bradrblack/vibration-monitor/(commit log)

2026-09-19 Add ESP32-C3 sump pump vibration monitor
    Reads an ADXL345 at 400 Hz, high-passes and RMS-windows the signal, and
    debounces a pump running/stopped state. Reports state changes (max one per
    minute) to the Adafruit IO "pump" feed and each run's exact length to
    "pump-run-seconds". LED shows movement, and blinks while the pump is on.
    Includes Wi-Fi reliability fixes (reduced TX power, radio reset and reboot
    fallback) and lib_ignore for WiFi101/WiFiNINA, which shadow the ESP32 WiFi.h.
    Claude-Session: https://claude.ai/code/session_016Ek1563o3tDYY9ggsTUYb5
    [pump-sensor.ino]
2026-09-20 Add reliability hardening and ntfy notifications
    Borrows the self-healing approach from the rf-ceiling-fan-remote firmware:
    - Bounded Wi-Fi connect at boot, Wi-Fi watchdog, Adafruit IO watchdog
    - Nightly 3 AM reboot (NVS-guarded, held off while pump running or a
    report is unsent)
    - Reboot reasons persisted to flash and pushed via ntfy.sh on next boot,
    including crash/watchdog/brownout detection
    - I2C hardening: ADXL345 device-ID watchdog, bus recovery at boot, and a
    notification if the sensor is missing
    - Last published state persisted so a reboot can't leave the feed stuck
    on "running"
    - Optional pump ON/OFF ntfy pushes, rate limited like the Adafruit feed
    - Timestamped logging and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
    [pump-sensor.ino]
2026-09-20 Generalize to multi-device appliance monitor with JSON events
    Rename pump-sensor.ino to vibration-monitor.ino, publish start/stop events
    as JSON to a shared appliance-events feed, and move per-device tuning into
    PlatformIO environments. README updated to match.
    [vibration-monitor.ino]
2026-09-20 Publish JSON events via MQTT and add I2C boot diagnostics
    Publish events through the Adafruit IO MQTT client (wrapped as {"value":...})
    because AdafruitIO_Feed::save() truncates payloads over 45 bytes.
    Add an I2C scan/idle-level log when the ADXL345 is not detected at boot, and
    retry accel.begin() up to 5 times since the first call often fails on the
    ESP32 Arduino 3.x I2C driver (ESP_ERR_INVALID_STATE) even when wired correctly.
    Bump firmware to 2026-09-20r9.
    [vibration-monitor.ino]
2026-09-21 Add Telegraf and Grafana setup for the InfluxDB appliance timeline
    Telegraf drop-in config subscribes to the Adafruit IO feed over MQTT and writes
    each start/stop event to InfluxDB 2.x as appliance_state, timestamped with the
    event's own time. Grafana dashboard shows an on/off timeline per device, current
    state, daily run time and recent runs. README documents setup.
2026-09-21 Add task watchdog and dryer env
    The main loop could hang (LED frozen, no serial output) with nothing to
    recover it, since the existing watchdogs run inside loop() itself. Arm a
    30 s hardware task watchdog at the end of setup() and feed it each loop;
    a hang now resets the board and checkUnexpectedReset() reports it via ntfy.
    Also add the [env:dryer] build environment and bump to 2026-09-21r10.
    Claude-Session: https://claude.ai/code/session_018x3jEM3jzxfcGkpqqV6ELK
    [vibration-monitor.ino]
2026-09-21 Make serial logging non-blocking
    A USB host that is attached but not reading could stall Serial writes and
    block the main loop. Set the TX timeout to 0 so excess output is dropped
    instead. Verified that logging resumes on its own once the host reads again.
    A guard on availableForWrite() was tried and removed: it stopped any write
    from being attempted, so logging never recovered after a stall.
    Bump to 2026-09-21r12.
    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
    [vibration-monitor.ino]
2026-09-22 Cap the Adafruit IO client timeout to stay under the task watchdog
    A stalled network call (DNS/TCP connect/TLS handshake) chained across
    WiFiClientSecure's default 3s per-call timeout could exceed the 30s hardware
    task watchdog before failing, which happened at least once (task watchdog
    reboot on the pump device). Expose the client via the AioWiFi subclass and
    cap it at 5s so any single serviceNetwork() pass stays well under that.
    Bump firmware to 2026-09-22r1.
    Claude-Session: https://claude.ai/code/session_018BaH7PLJXob49S84QUoqu3
    [vibration-monitor.ino]
